vdelarosaj/flattop-micro/docs/landing.md

# OpenFlexure flat-top microscope

These are the instructions for the "flat top" version of the [OpenFlexure Microscope].  It uses the same focusing mechanism and optics module as v6.1 of the regular microscope, but replaces the XY stage with a large laser cut plate.  This is big enough to allow 96-well plates, mobile phones, petri dishes, or other large objects to be imaged.  Currently it doesn't come with any illumination; I've only used it for a practical class where students were looking at their mobile phone screens.  However, there are holes in the top plate to allow the illuminator from the [OpenFlexure Microscope] to be bolted on, or you can use the reflection version of the microscope optics module.

The assembled microscope

## Assembly
The assembly is detailed in the steps below:

* [Bill of materials]({{BOMlink}})
* [Prepare the laser cut plates](1_preparing_laser_cut_parts.md){step: True}
* [Assemble the focus mechanism](2_assemble_focus_mechanism.md){step: True}
* [Attach parts to the top plate](3_attach_parts_to_the_top_plate.md){step: True}
* [Attach the bottom plate](4_attach_bottom_plate.md){step: True}
* [Attach the optics and other parts](5_attach_components.md){step: True}

[OpenFlexure Microscope]: https://openflexure.org/projects/microscope/
