vdelarosaj/flattop-micro/docs/3_attach_parts_to_the_top_plate.md

# Attach parts to the top plate

{{BOM}}

The parts required for this step

## Method
### Prepare the standoffs
Insert a [M3x6mm cap head screw]{qty: 4} into each [standoff]{qty: 4} using the large hole that comes out the side of the [standoff].  When you are done, the screw should poke out the end of the part as shown.  There should be four spacers, one for each corner of the plate.  It's probably easiest to use a non-ball-ended hex key to put the screw into place, then use a [2.5mm ball-ended hex key]{qty:1} to turn the screw.  The hole may print a little tight - you can either clean it up with a 3mm drill, or simply turn the screw a few times before attaching it to the plate, to ensure any thread that might have formed is stripped away.




[M3x6mm cap head screw]: parts/m3x6mm_cap_head_screw.md
[standoff]: parts/standoff.md
[2.5mm ball-ended hex key]: parts\2_5_mm_hex_key.md "{cat:tool}"

### Attach the standoffs
Attach each [standoff] to one of the corners of the [top plate].




[top plate]: parts/top_plate.md

### Attach the focusing assembly
Using a [M3x6mm cap head screw]{qty: 2} on either side of the [focusing assembly], attach it to the top plate.




[focusing assembly]: parts/focusing_assembly.md

The top plate is now assembled, you can proceed to attach the bottom plate.
