vdelarosaj/flattop-micro/docs/1_preparing_laser_cut_parts.md

# Preparing the laser-cut plates

Before assembling the microscope, you will need to tap the holes in the laser cut acrylic sheets so you can screw M3 screws into them.

{{BOM}}
[top plate]: parts/top_plate.md "{cat:lasercutpart}"
[bottom plate]: parts/bottom_plate.md "{cat:lasercutpart}"
[M3 tap]: parts/m3_tap.md "{cat:tool}"
[tap wrench]: parts/tap_wrench.md "{cat:tool}"
[lubricant]: parts/tap_lubricant.md "{cat:tool}"

## Method

The two laser-cut perspex sheets, the [top plate] and the [bottom plate], have a number of holes in them that need to be tapped.

### Tap holes in the top plate
Use an [M3 tap]{qty:1} mounted in a [tap wrench]{qty:1} to tap all the holes in the [top plate]{qty:1}.  It helps to use some [lubricant]{qty:a little} when you tap the holes, and to make 2 turns "screwing in" the tap then half a turn "unscrewing" as described in the [guide to tapping acrylic].  All of the holes in the [top plate] are intended to be tapped, there are no M3 through holes here.  It's probably easiest to tap the holes before removing any protective film from the acrylic, to help keep any debris off the plastic.



### Tap holes in the bottom plate
There are several holes in the [bottom plate]{qty:1} that should be tapped.  However, there are both tapped and through holes in the bottom plate: if the hole is too big, and the [M3 tap]] fits in without "biting" the plastic, you probably don't need to tap the hole.  The most important two holes to tap at this point are the ones either side of the focusing method, where the tap wrench is placed in the photo below.  The others can all be tapped later if required.



### Clean up through holes
If any of the M3 clearance holes in the bottom plate are too tight to get an M3 screw through comfortably, you could open them up using a 3mm drill bit at this point.

### Remove film
If there is protective film on the acrylic, remove it now.

Your plates are now prepared and ready to use.

[guide to tapping acrylic]: http://www.ultimatehandyman.co.uk/how-to/acrylic/tapping-acrylic
