vdelarosaj/flattop-micro/(list of files, cad)

Other CAD files:
openscad/standoffs.scad
