vdelarosaj/flattop-micro/(commit log)

2020-02-14 initial commit - working, with one assembly hitch
    [focusing_assembly.scad, parameters.scad, plates.scad, standoffs.scad, top_plate.scad]
2020-03-06 moved mounting holes for easier assembly
    [focusing_assembly.scad, plates.scad]
2020-03-12 Fixed the hole diameters and added access for hex key
    [plates.scad, top_plate.scad]
2020-05-28 Added assembly instructions (incomplete)
2020-06-16 taller standoffs
    The design was using 35mm parfocal objectives, which are less
    common. I've raised it up 10mm to use 45mm objectives, which
    are more widely used.
    I also fixed a typo in plates.scad that I'd accidentally committed.
    [parameters.scad, plates.scad, standoffs.scad]
2020-07-06 Copy STL/DXF into pages/CAD
